Heymaker69/Low-Pass-Filter-Design-and-Fabrication/final New Project 2/New Data/Design Physical Pic.JPG

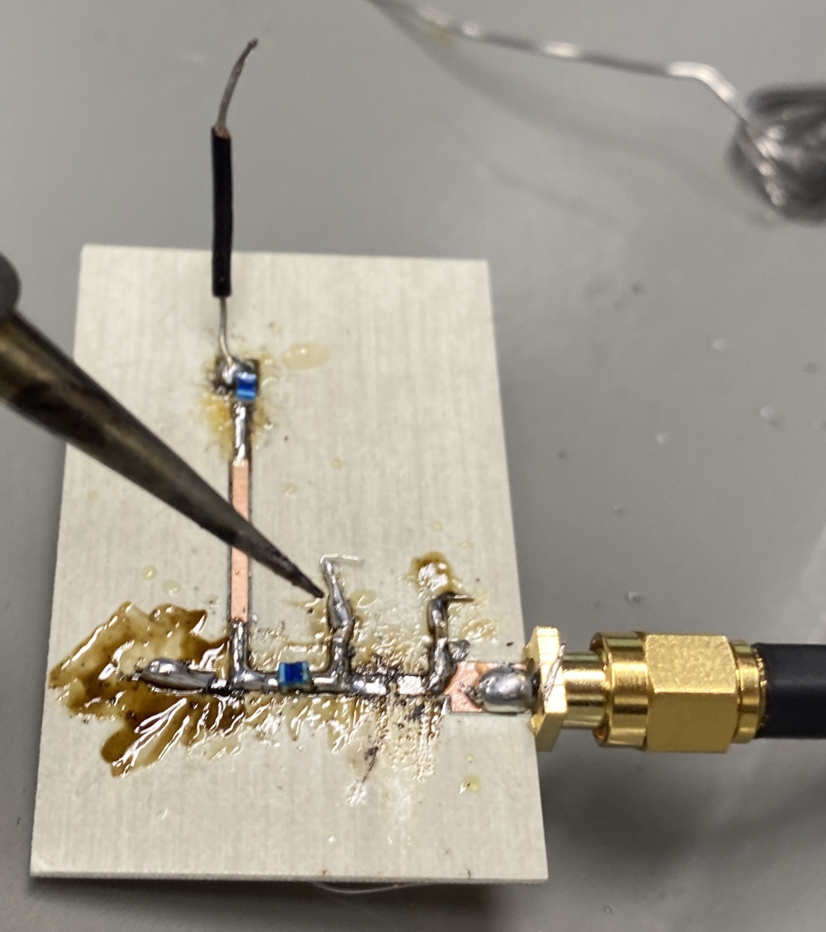
final New Project 2/New Data/Design Physical Pic.JPG
