Heymaker69/Low-Pass-Filter-Design-and-Fabrication/final New Project 2/New Data/Table Data.JPG

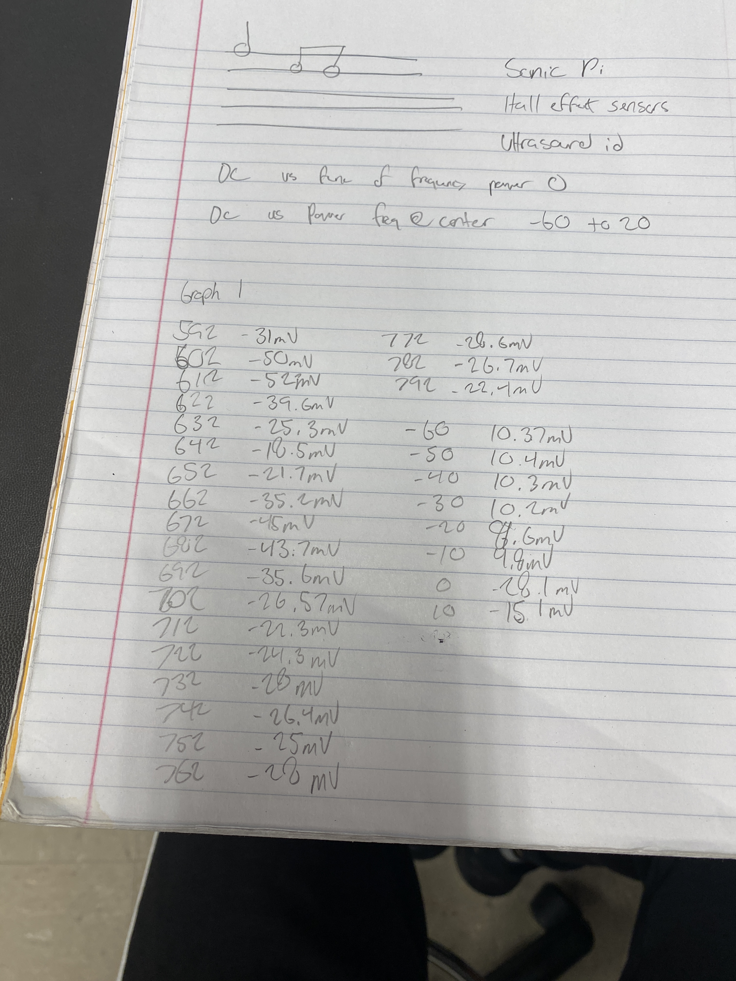
final New Project 2/New Data/Table Data.JPG
