Heymaker69/Low-Pass-Filter-Design-and-Fabrication/Adding Large C.png

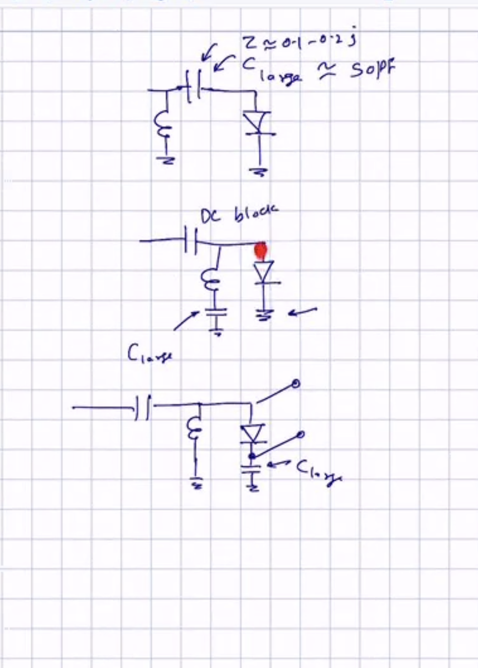
Adding Large C.png
