Heymaker69/Low-Pass-Filter-Design-and-Fabrication/Data/Diode Value using S1P at 0.915.png

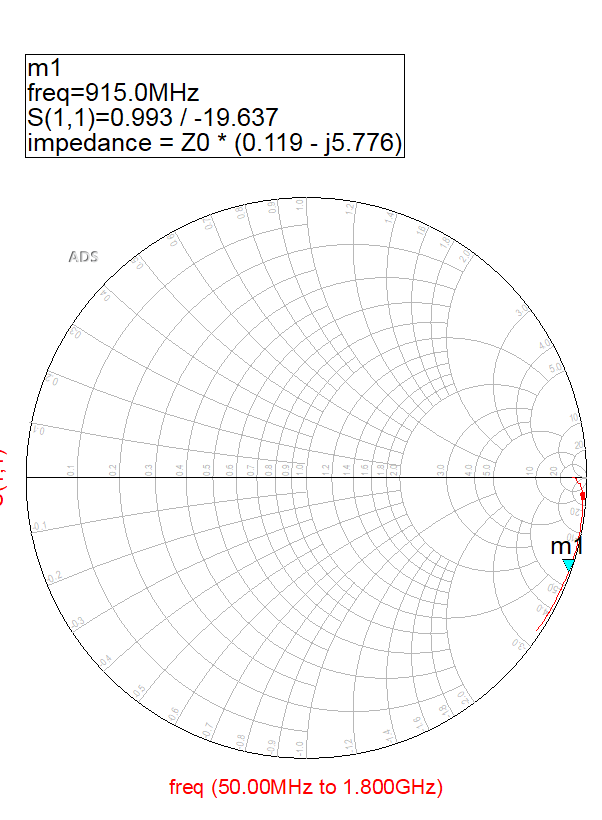
Data/Diode Value using S1P at 0.915.png
