Heymaker69/Low-Pass-Filter-Design-and-Fabrication/Data/Lumped Elements Design.png

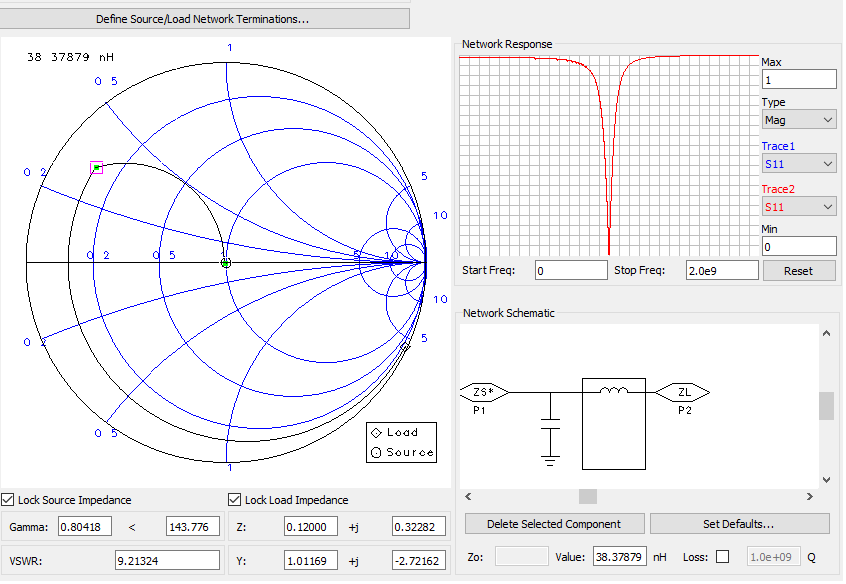
Data/Lumped Elements Design.png
