Heymaker69/Low-Pass-Filter-Design-and-Fabrication/Data/S11 at 0.915.png

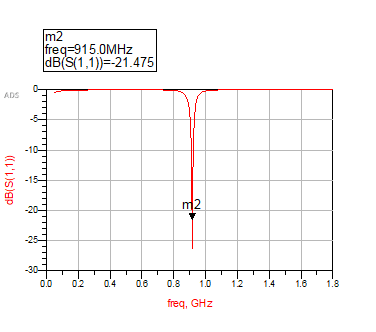
Data/S11 at 0.915.png
