Heymaker69/Low-Pass-Filter-Design-and-Fabrication/Data/smith and graph at 915 MHZ.png

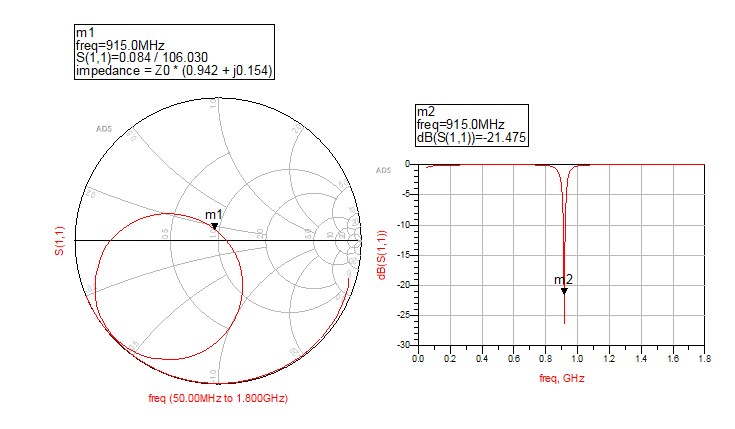
Data/smith and graph at 915 MHZ.png
