Heymaker69/Low-Pass-Filter-Design-and-Fabrication/final New Project 2/After Calculations/Design for Exporting.png

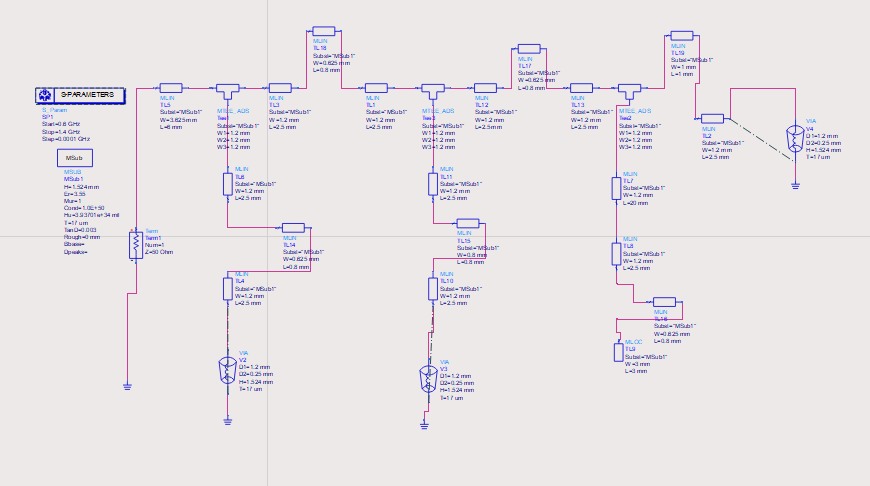
final New Project 2/After Calculations/Design for Exporting.png
