Heymaker69/Low-Pass-Filter-Design-and-Fabrication/final New Project 2/New Data/Design after adding lengths.png

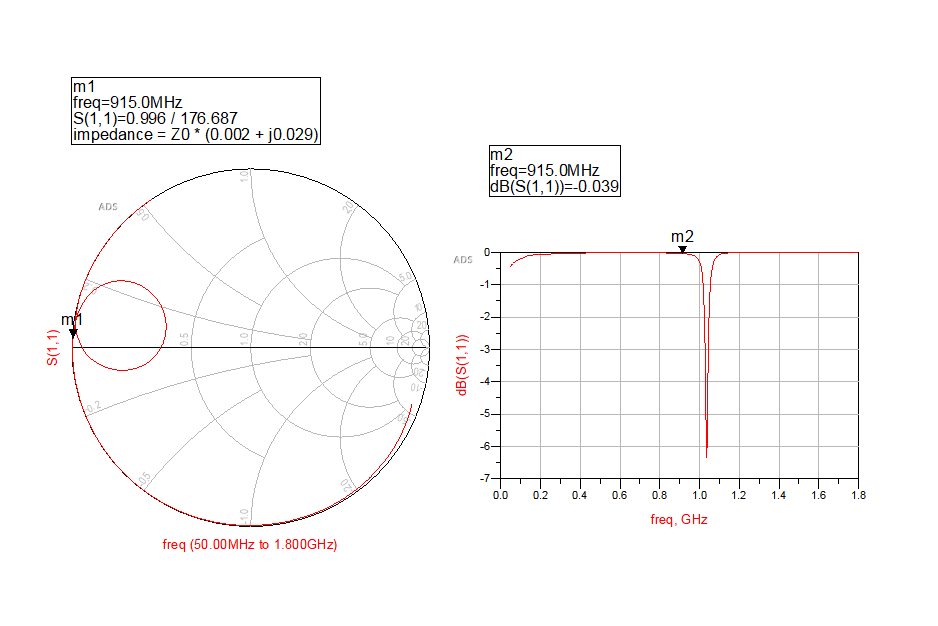
final New Project 2/New Data/Design after adding lengths.png
