Heymaker69/Low-Pass-Filter-Design-and-Fabrication/final New Project 2/New Data/Design with lengths.png

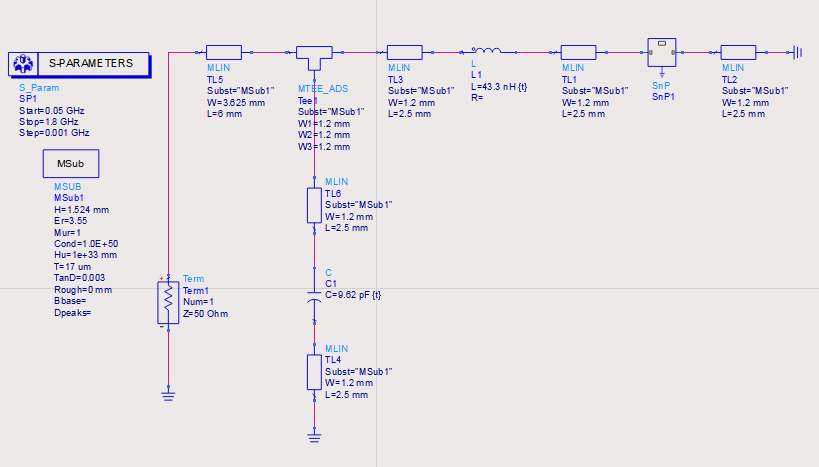
final New Project 2/New Data/Design with lengths.png
