Heymaker69/Low-Pass-Filter-Design-and-Fabrication/final New Project 2/New Data/New design/4 element design.png

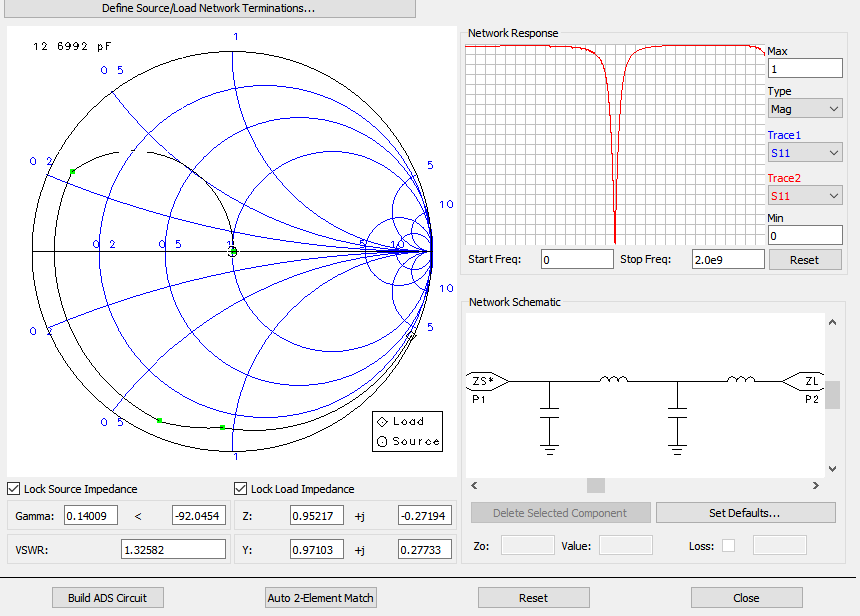
final New Project 2/New Data/New design/4 element design.png
