Heymaker69/Low-Pass-Filter-Design-and-Fabrication/final New Project 2/New Data/New design/Basic values without 2nd cond.png

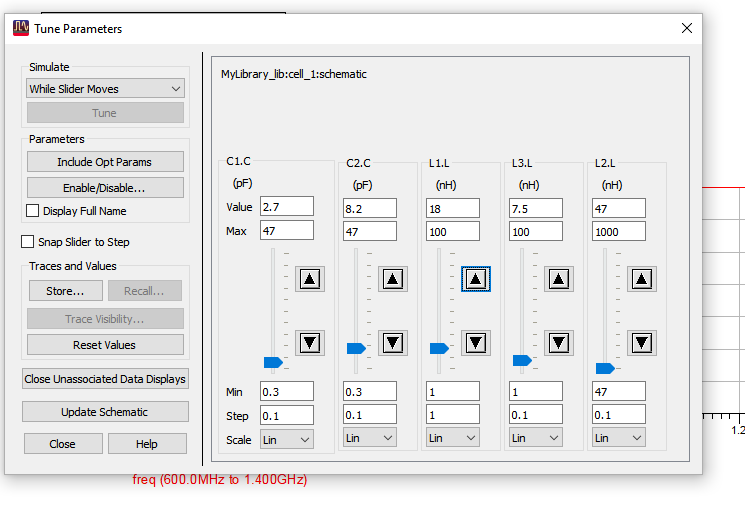
final New Project 2/New Data/New design/Basic values without 2nd cond.png
