Heymaker69/Low-Pass-Filter-Design-and-Fabrication/final New Project 2/New Data/New design/Final 3 marker design.png

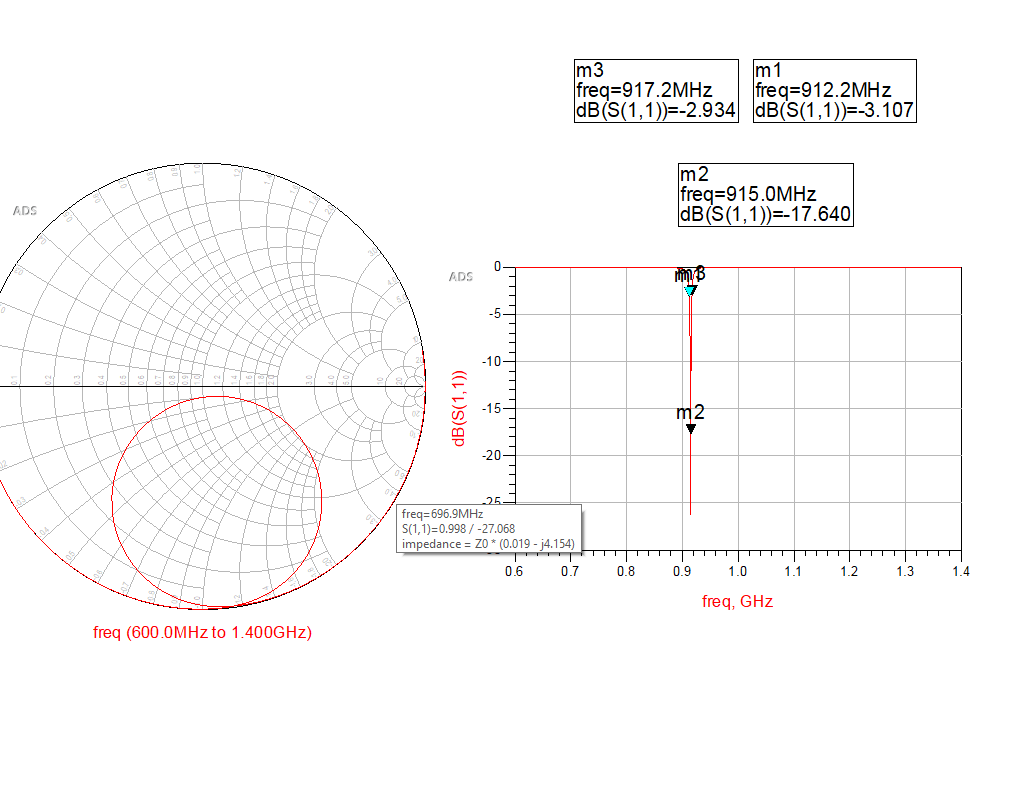
final New Project 2/New Data/New design/Final 3 marker design.png
