Heymaker69/Low-Pass-Filter-Design-and-Fabrication/final New Project 2/New Data/Proping for V.png

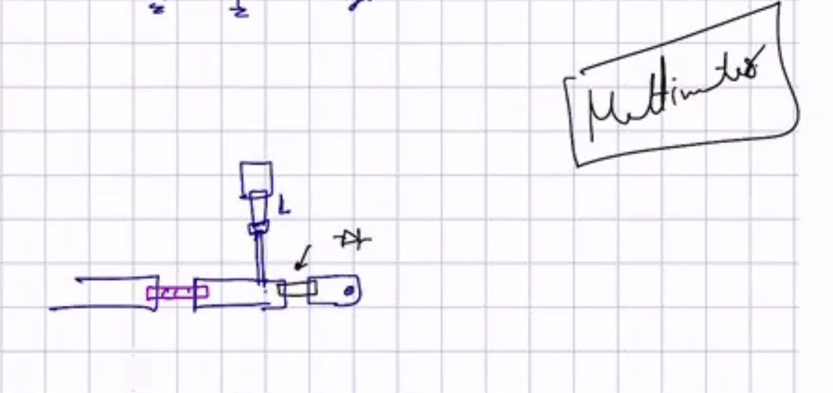
final New Project 2/New Data/Proping for V.png
