Heymaker69/Low-Pass-Filter-Design-and-Fabrication/final New Project 2/New Data/S2p.png

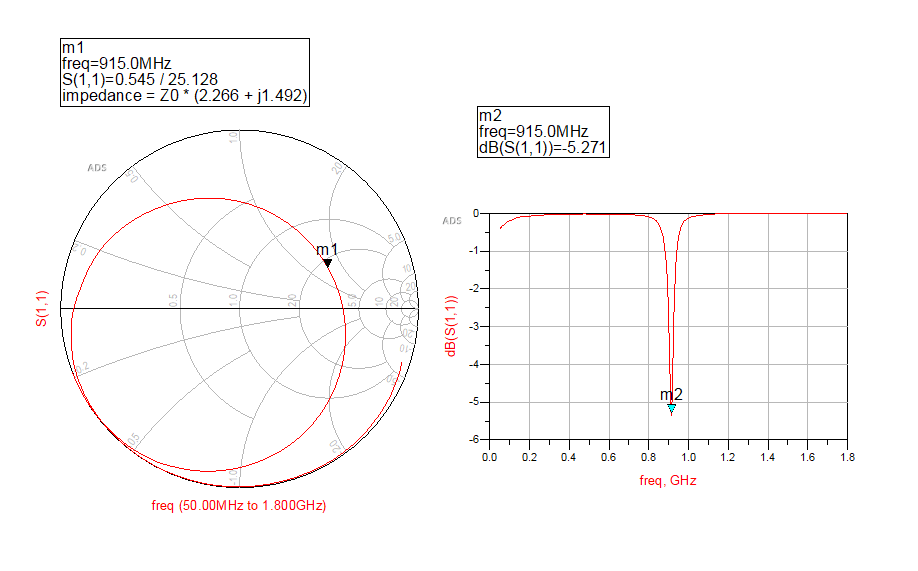
final New Project 2/New Data/S2p.png
