Heymaker69/Low-Pass-Filter-Design-and-Fabrication/final New Project 2/New Data/Screen Shot 2021-12-05 at 10.47.25 PM.png

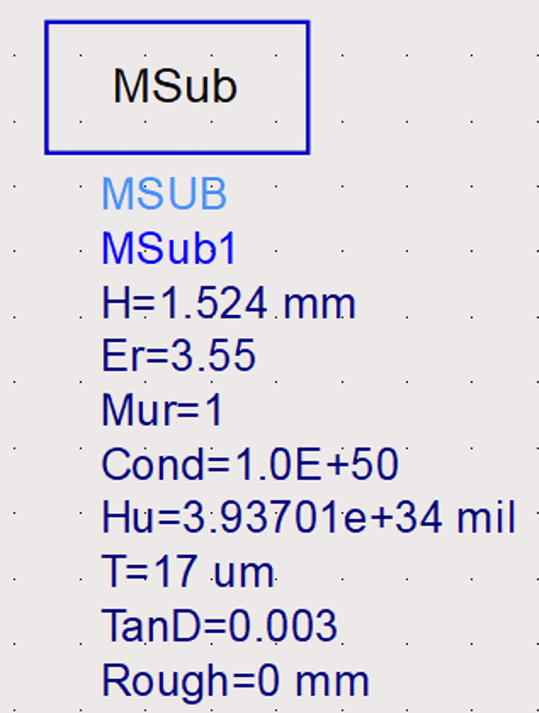
final New Project 2/New Data/Screen Shot 2021-12-05 at 10.47.25 PM.png
