Heymaker69/Low-Pass-Filter-Design-and-Fabrication/final New Project 2/New Data/Swapping Elements for Exporting Design.png

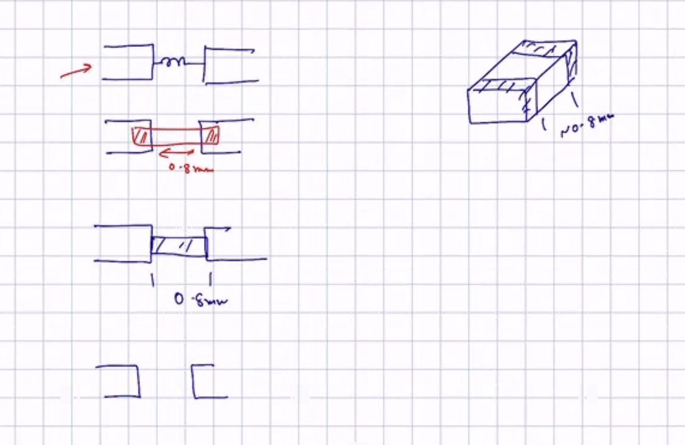
final New Project 2/New Data/Swapping Elements for Exporting Design.png
