Heymaker69/Low-Pass-Filter-Design-and-Fabrication/final New Project 2/New Data/New design/replaing components for exporting.png

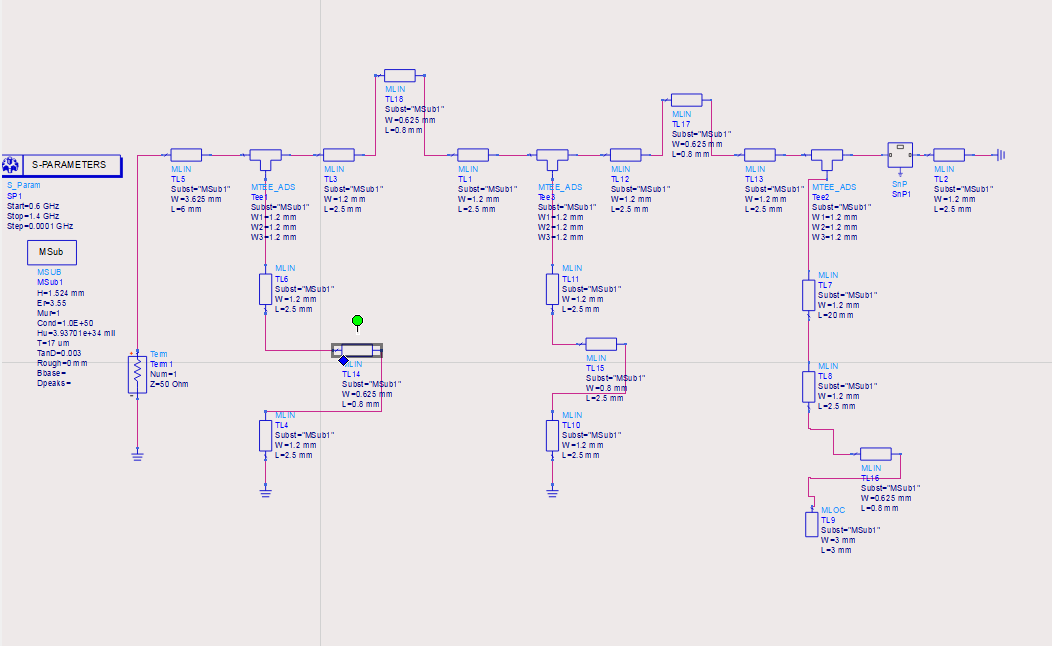
final New Project 2/New Data/New design/replaing components for exporting.png
