Heymaker69/Low-Pass-Filter-Design-and-Fabrication/(list of files, cad)

Other CAD files:
final New Project 2/MyWorkspace_wrk/mfg/MyLibrary_lib_cell_1/dxf/cell_1.dxf
final New Project 2/Project2_design.dxf
final New Project 2/Final_Final_Project2.dxf
