Heymaker69/Low-Pass-Filter-Design-and-Fabrication/final New Project 2/New Data/After Tune.png

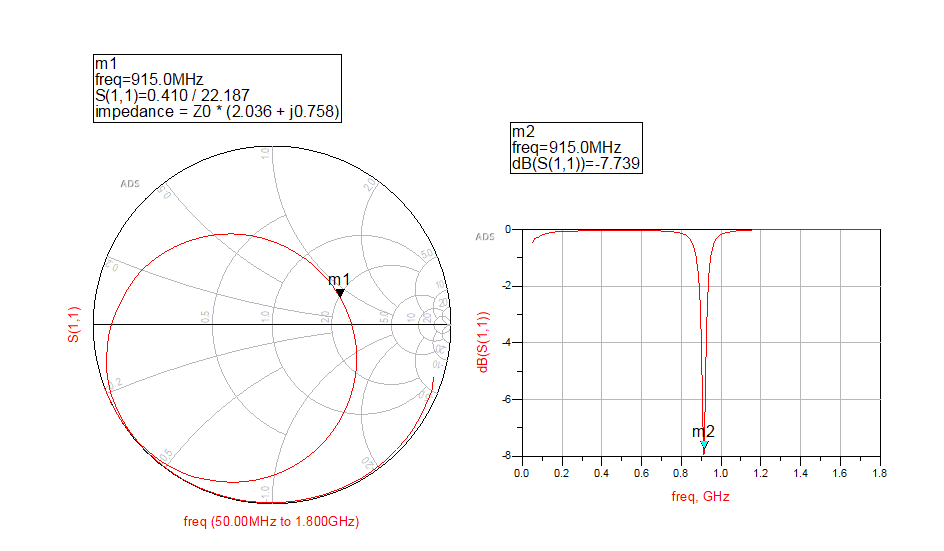
final New Project 2/New Data/After Tune.png
